Shep-pard/stmbl/hw/kicad/Chopper_v2/doc/Unbenannt.PNG

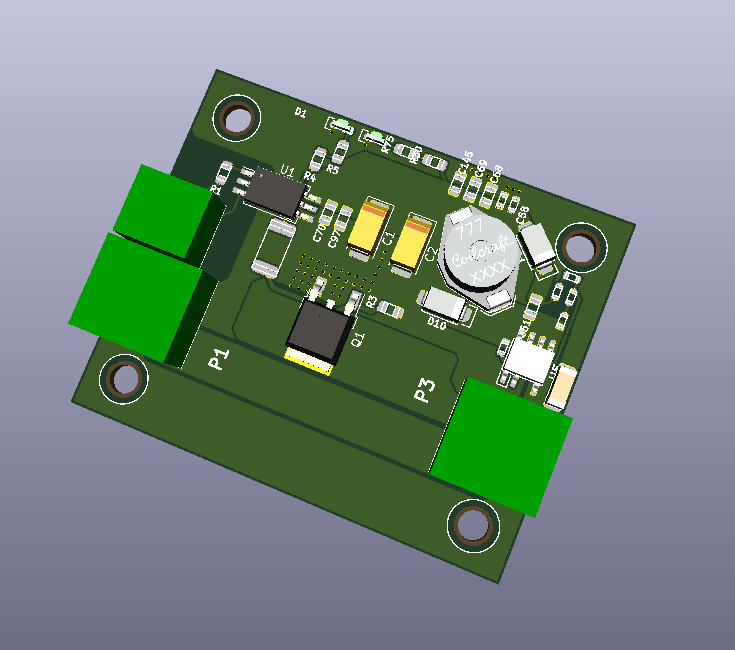
hw/kicad/Chopper_v2/doc/Unbenannt.PNG
