Shep-pard/stmbl/hw/kicad/v4.012/v4.0/doc/TeilePositionen.pptx

SMAJ24A

G

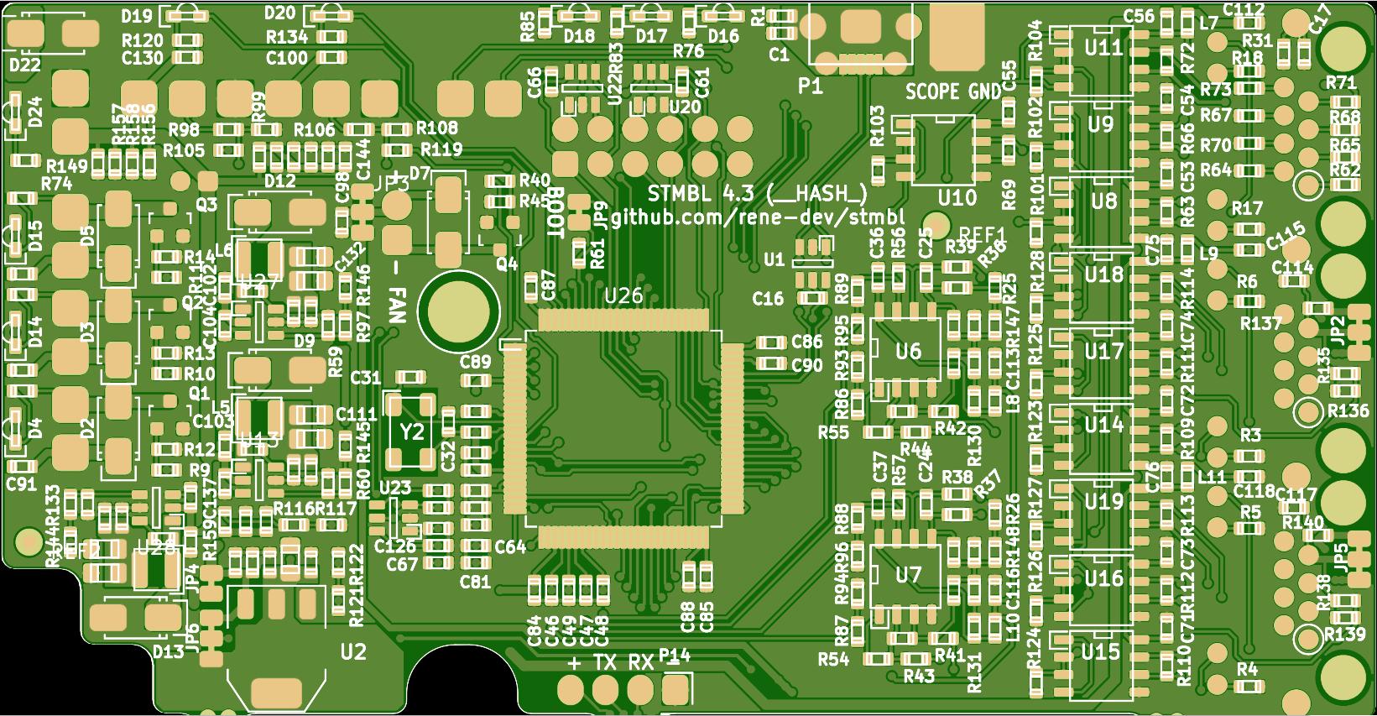
[picture p2: figure]

LED G

LED G

LED G

Y

R

G

L6 10u

G

ACT4088

G

L5 4.7u

8Mhz

ACT4088

ACT4088

L12 4.7u

U2 zldo1117

## Slide 2

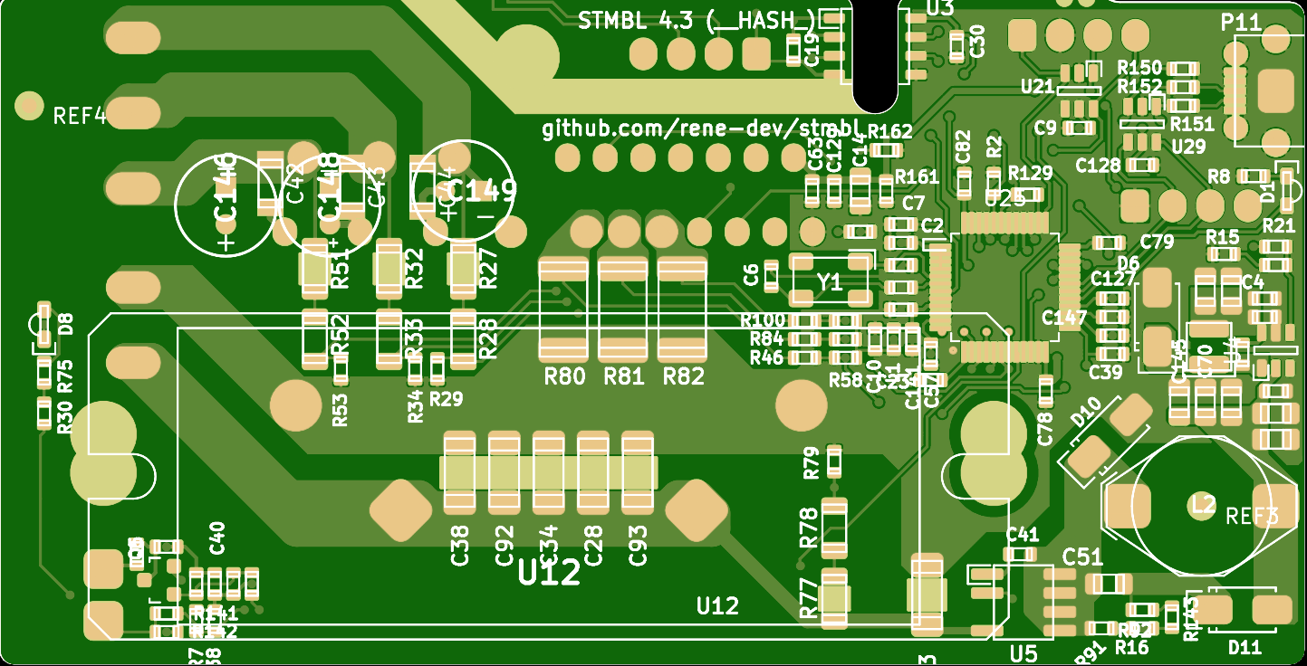
[picture p3: figure]

SI8621

3x22uF

LED R

LED G

3x3mΩ

8Mhz

L4 10u

ACT4088

18pF back

5x150nF

L2 1mH

150nF

LNK
304D
