Shep-pard/stmbl/hw/kicad/Copper/doc/Bestueckung.PNG

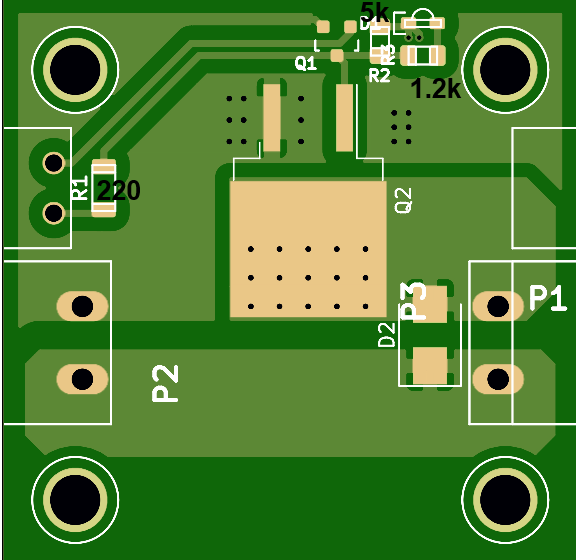
hw/kicad/Copper/doc/Bestueckung.PNG
