Shep-pard/stmbl/hw/kicad/v4.012/v4.0/doc/GerberView.PNG

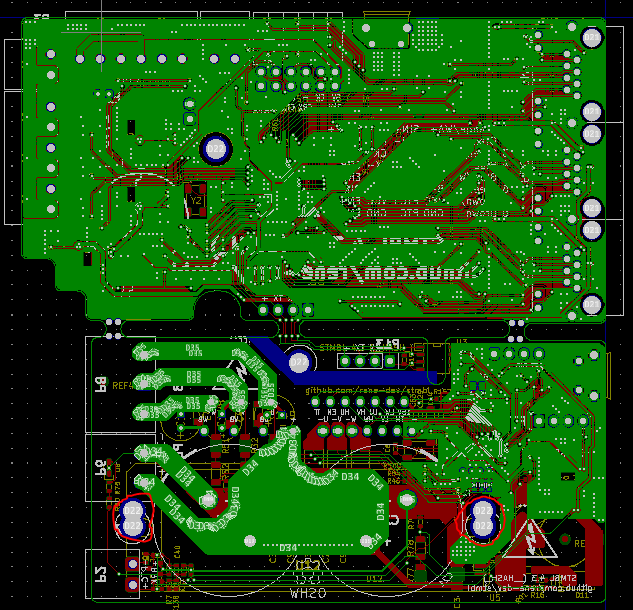
hw/kicad/v4.012/v4.0/doc/GerberView.PNG
