Shep-pard/stmbl/hw/kicad/v4.012/v4.0/doc/Stecker.PNG

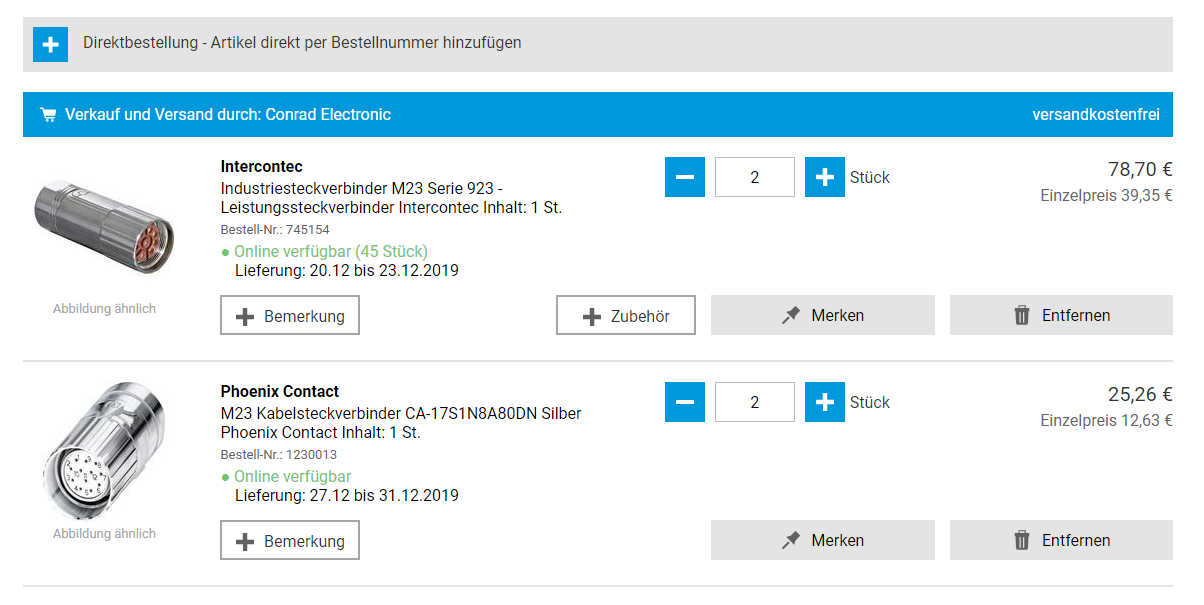
hw/kicad/v4.012/v4.0/doc/Stecker.PNG
