Shep-pard/stmbl/hw/kicad/Copper/doc/JLCSMT_BOM.xlsx

Comment | Designator | Footprint | LCSC Part #
220 | R1 | R_1206 | C17958
5k | R2 | R_1206 | C17936
2N7002 | Q1 | SOT-23 | C8545
 | Q2 | TO-263-2 | C314017
