Shep-pard/stmbl/hw/kicad/v4.012/v4.0/doc/JLCSMT_BOM_2.xlsx

Comment | Designator | Footprint | LCSC Part #
100nF | C19,C30,C127,C138,C40,C78,C79,C82,C83,C2,C7,C10,C9,C128,C58,C41,C15,C60,C63,C147,C106,C105,C96,C108,C107,C103,C104,C99,C121,C122,C120,C53,C54,C55,C56,C17,C112,C72,C74,C75,C13,C36,C113,C115,C114,C125,C71,C73,C76,C12,C37,C116,C118,C117,C126,C91,C94,C95,C100,C130,C98,C89,C87,C86,C85,C84,C80,C77,C29,C16,C119,C1,C61,C66,C67 | 0603_C | C14663
10uF | C51,C35,C68,C69,C4,C97,C70,C145,C14,C110,C109,C111,C123,C124,C132,C131 | 0805_C | C15850
18pF | C5,C6,C11,C20,C23,C39,C33,C45,C57,C25,C27,C24,C26,C31,C32 | 0603_C | C1647
2.2uF | C141,C50,C42,C43,C44,C129,C18,C8,C101,C102,C136,C135,C134,C137,C133,C62,C139,C140,C142,C144,C90,C88,C65 | 0603_C | C23630
1nF | C47,C48,C46,C49,C52,C59,C81,C64 | 0603_C | C1588
120? | R31,R109,R111,R114,R24,R25,R130,R110,R112,R113,R23,R26,R131,R1 | 0603_R | C22787
1K? | R162,R165,R2,R129,R118,R91,R75,R30,R15,R16,R145,R63,R66,R69,R72,R101,R102,R103,R104,R123,R125,R128,R136,R124,R126,R127,R139,R12,R13,R14,R45,R119,R108,R105,R99,R117,R121,R122,R61,R153 | 0603_R | C21190
470? | R8,R46,R84,R100,R17,R18,R3,R6,R93,R95,R4,R5,R94,R96,R134,R120,R85,R83,R76 | 0603_R | C23179
10K? | R142,R7,R115,R35,R132,R158,R155,R156,R157,R62,R64,R65,R67,R68,R70,R71,R73,R42,R44,R36,R39,R137,R135,R41,R43,R37,R38,R140,R138,R106,R98,R116 | 0603_R | C25804
22? | R163,R167,R151,R152,R154,R159,R160,R86,R89,R147,R87,R88,R148,R9,R10,R11,R40 | 0603_R | C23345
15K? | R92,R19,R58,R90,R107,R47,R55,R50,R56,R48,R54,R49,R57 | 0603_R | C22809
3.9K? | R164,R166,R161,R29,R34,R53,R79,R59,R146,R144,R149,R20,R22,R74 | 0603_R | C23018
51K? | R141,R21,R97,R60,R133 | 0603_R | C23196
249K? | R27,R28,R32,R33,R51,R52,R77,R78 | 1206_R | C37158
1.5K? | R143,R150 | 0603_R | C22843
LM358 | U6,U7 | SOIC-8-N | C7950
SN65176B | U8,U9,U10,U11,U14,U17,U18,U15,U16,U19 | SOIC-8-N | C31302
STM32F303CBTx | U25 | LQFP-48_7x7mm_Pitch0.5mm | C108516
STM32F405VG | U26 | LQFP-100_14x14mm_Pitch0.5mm | C56621
USBLC6-4SC6 | U21,U29,U1,U23,U20,U22 | SOT-23-6 | C252436
ES1J R2 | D10,D11,D2,D3,D5,D7 | DO-214AC | C84166
220r 700mA | L1,L7,L8,L9,L10,L11,L3 | 0603_R | C98286
SS34A | D6,D12,D9,D13 | stmbl:SMA_Standard | C183891
IRLML6344 | Q5,Q1,Q2,Q3,Q4 | stmbl:SOT-23 | C53550
