Shep-pard/stmbl/hw/kicad/v4.012/v4.0/doc/Bauteile.xlsx

Val | Designator | Package
ACT4088 | U4,U13,U28,U27 | stmbl:SOT-23-6 | Pin 1 ist am F. Die zwei minus zeichen sind an pin 5.
10µH 1A | L4,L6 | stmbl:SMD_INDUCTOR_32x25
4.7ÂµH 1.5A | L5,L12 | stmbl:SMD_INDUCTOR_32x25
1m 250mA | L2 | stmbl:NPI31W
SI8621 | U3 | stmbl:SOIC-8-N
zldo1117 | U2 | SOT-223 | Pin 1 ist am F. Die zwei minus zeichen sind an pin 5.
LNK?304D | U5 | SOIC-7
STK554U392A | U12 | stmbl:IRAM256
8M | Y1,Y2 | Crystal_SMD_0503_4Pads
270µH | C21,C22 | stmbl:C_Radial_D26_L45_P10 | Die fetten 330uF
150n | C3,C28,C34,C38,C93,C92 | stmbl:C_1808
USB_OTG | P11,P1 | stmbl:USB_Micro-B
0.003 | R80,R81,R82 | stmbl:R_2512
SMAJ24A TVS 24V | D22 | stmbl:SMA_Standard
red | D1,D16 | stmbl:LED-0805-SIDE | Der grüne Strich ist je minus
yellow | D17 | stmbl:LED-0805-SIDE | Der grüne Strich ist je minus
green | D8,D24,D4,D14,D15,D20,D19,D18 | stmbl:LED-0805-SIDE | Der grüne Strich ist je minus
47uF | C146,148,149 | For STK Other Possibility! | Andere Möglichkeit als bootstrapping C
22uF | C146,148,149 | For STK
18pF | C20,C33,C45 | moved filter caps | die drei Cs auf der Rückseite der HV Platine
2.2uF | C42,43,44 | When using IRAM!
22uF | C143 | stmbl:C_Radial
Bridge Rectifier
CONN_02X06 | P10 | stmbl:Socket_Strip_Angled_2x06 | Pinheader hat man ja immer irgendwo :D
CONN_01X04 | P12,P7 | stmbl:Pin_Header_Straight_1x04
CONN_01X04 | P13 | stmbl:Socket_Strip_Straight_1x04
CONN_01X02 | P4 | stmbl:Pin_Header_Angled_1x02
CONN_01X04 | P14 | stmbl:Pin_Header_Angled_1x04
CONN_01X02 | P2,P3,P15 | stmbl:RM3.5_1x2
 |  | stmbl:RM3.5_1x2_plug
CONN_01X02 | P6 | stmbl:RM5.08_1x2
 |  | stmbl:RM5.08_1x2_plug
CONN_01X03 | P8 | stmbl:RM5.08_1x3
 |  | stmbl:RM5.08_1x3_plug
CONN_01X06 | P5,P9 | stmbl:RM3.5_1x6
 |  | stmbl:RM3.5_1x6_plug
