Shep-pard/stmbl/hw/kicad/v4.012/v4.0/doc/RestlicheBauteile.xlsx

Val | Designator | Package | JLC_Nbr | Manufacturer | Product ID |  |  | Amount: | Cost Single | Cost total | Platform
ACT4088 | U4,U13,U28,U27 | stmbl:SOT-23-6 | C11135 | Active-Semi | ACT4088US-T (https://lcsc.com/product-detail/DC-DC-Converters_ACTIVE-SEMI-ACT4088US-T_C11135.html) |  |  | 4 | 0.41 € | 1.64 € | lcsc
10ÂµH 1A | L4,L6 | stmbl:SMD_INDUCTOR_32x25 |  | Murata | LQH32PN100MNCL (https://lcsc.com/product-detail/Power-Inductors_Murata-Electronics-LQH32PN100MNCL_C86073.html) |  |  | 2 | 0.468 | 0.94 € | mouser
1m 250mA | L2 | stmbl:NPI31W | C280665 | Coilcraft | SSL0804T-102M-N (https://lcsc.com/product-detail/_Chilisin-Elec-SSL0804T-102M-N_C280665.html) |  |  | 1 | 0.2222 | 0.22 € | lcsc
CONN_01X04 | P14 | stmbl:Pin_Header_Angled_1x04 | C293357 |  | 901210764 (https://lcsc.com/product-detail/Pin-Header-Female-Header_MOLEX-901210764_C293357.html) |  |  | 1 | 0.31 | 0.31 € | lcsc
CONN_01X02 | P2,P3,P15 | stmbl:RM3.5_1x2 | C395830 | DIBO | DB2ERC-3.5-2P (https://lcsc.com/product-detail/Pluggable-System-Terminal-Block_DIBO-DB2ERC-3-5-2P_C395830.html) |  |  | 3 | 0.033 | 0.10 € | lcsc
 |  | stmbl:RM3.5_1x2_plug | C395828 | DIBO | DB2EK-3.5-2P (https://lcsc.com/product-detail/Pluggable-System-Terminal-Block_DIBO-DB2EK-3-5-2P_C395828.html) |  |  | 3 | 0.099 | 0.30 € | lcsc
CONN_01X02 | P6 | stmbl:RM5.08_1x2 | C3697 | DIBO | WJ2EDGRC-5.08-2P (https://lcsc.com/product-detail/Pluggable-System-Terminal-Block_Ningbo-Kangnex-Elec-WJ2EDGRC-5-08-2P_C3697.html) |  |  | 1 | 0.0233 | 0.02 € | lcsc
 |  | stmbl:RM5.08_1x2_plug | C71370 | DIBO | WJ2EDGK-5.08-2P (https://lcsc.com/product-detail/Pluggable-System-Terminal-Block_Ningbo-Kangnex-Elec-WJ2EDGK-5-08-2P_C71370.html) |  |  | 1 | 0.0953 | 0.10 € | lcsc
CONN_01X03 | P8 | stmbl:RM5.08_1x3 | C8377 | DIBO | WJ2EDGRC-5.08-3P (https://lcsc.com/product-detail/Pluggable-System-Terminal-Block_Ningbo-Kangnex-Elec-WJ2EDGRC-5-08-3P_C8377.html) |  |  | 1 | 0.0349 | 0.03 € | lcsc
 |  | stmbl:RM5.08_1x3_plug | C71371 | DIBO | WJ2EDGK-5.08-3P-14-00A (https://lcsc.com/product-detail/Pluggable-System-Terminal-Block_Ningbo-Kangnex-Elec-WJ2EDGK-5-08-3P-14-00A_C71371.html) |  |  | 1 | 0.1336 | 0.13 € | lcsc
CONN_01X06 | P5,P9 | stmbl:RM3.5_1x6 | C39583 | DIBO | DB2EK-3.5-6P (https://lcsc.com/product-detail/Pluggable-System-Terminal-Block_DIBO-DB2EK-3-5-6P_C395838.html) |  |  | 2 | 0.099 | 0.20 € | lcsc
 |  | stmbl:RM3.5_1x6_plug | C395838 | DIBO | DB2ERC-3.5-6P (https://lcsc.com/product-detail/Pluggable-System-Terminal-Block_DIBO-DB2ERC-3-5-6P_C395837.html) |  |  | 2 | 0.217 | 0.43 € | lcsc
zldo1117 | U2 | SOT-223 | C326523 |  | ZLDO1117QG33TA (https://lcsc.com/product-detail/Linear-Voltage-Regulators_Diodes-Incorporated-ZLDO1117QG33TA_C326523.html) |  |  | 1 | 0.297 | 0.30 € | lcsc
LNK?304D | U5 | SOIC-7 | C37448 |  | LNK304DN-TL (https://lcsc.com/product-detail/Switching-Controllers_POWER-INTEGRATIONS-LNK304DN-TL_C37448.html) |  |  | 1 | 0.569 | 0.57 € | lcsc
8M | Y1,Y2 | Crystal_SMD_0503_4Pads | C276420 |  | ABM3B-8.000MHZ-10-1-U-T (https://lcsc.com/product-detail/SMD-Crystal-Resonators_Abracon-LLC-ABM3B-8-000MHZ-10-1-U-T_C276420.html) |  |  | 2 | 0.35 € | 0.70 € | lcsc
270Âµ | C21,C22 | stmbl:C_Radial_D26_L45_P10 |  | United Chemi-Con | ESMR401VSN271MQ30S |  | 400V | 2 | 0 | 0.00 €
150n | C3,C28,C34,C38,C93,C92 | stmbl:C_1808 |  | KEMET | C1808W154KCRACTU | X7R | 500V | 6 | 0.63 € | 3.78 € | mouser
4.7ÂµH 1.5A | L5,L12 | stmbl:SMD_INDUCTOR_32x25 |  | Murata | LQH32PN4R7NNC |  |  | 2 | 0.468 | 0.94 € | mouser
CONN_02X06 | P11,P1 | stmbl:USB_Micro-B |  | Molex | 105017-0001 |  |  | 2 | 0.774 | 1.55 € | mouser
USB_OTG | P10 | stmbl:Socket_Strip_Angled_2x06 |  | das hat doch echt jeder! |  |  |  | 1 |  | 0.00 €
CONN_01X04 | P12,P7 | stmbl:Pin_Header_Straight_1x04 |  |  |  |  |  | 2 |  | 0.00 €
CONN_01X04 | P13 | stmbl:Socket_Strip_Straight_1x04 |  |  |  |  |  | 1 |  | 0.00 €
CONN_01X02 | P4 | stmbl:Pin_Header_Angled_1x02 |  |  |  |  |  | 1 |  | 0.00 €
SI8621 | U3 | stmbl:SOIC-8-N |  | Silicon Labs | Si8621BB-B-IS |  |  | 1 | 1.32 | 1.32 € | mouser
0.003 | R80,R81,R82 | stmbl:R_2512 |  | Bourns | CSS2H-2512K-3L00F |  | 1% | 3 | 0.864 | 2.59 € | mouser
IRAM256a | U12 | stmbl:IRAM256 |  | Onsemi | STK554U392A |  |  | 1 | 10.00 € | 10.00 € | ali | https://de.aliexpress.com/item/32983001276.html
red | D1,D16 | stmbl:LED-0805-SIDE | C284935 | Lite-On | LTST-S220KRKT (https://lcsc.com/product-detail/Light-Emitting-Diodes-LED_Lite-On-LTST-S220KRKT_C284935.html) |  |  | 2 | 0.0376 | 0.08 € | lcsc
yellow | D17 | stmbl:LED-0805-SIDE | C264355 | Lite-On | 12-215/Y2C-CQ1R1B/3C (https://lcsc.com/product-detail/Others_Everlight-Elec-12-215-Y2C-CQ1R1B-3C_C264355.html) |  |  | 1 | 0.0415 | 0.04 € | lcsc
SMAJ24A TVS 24V | D22 | stmbl:SMA_Standard | C132947 | STMicroelectronics | SMAJ24A-TR (https://lcsc.com/product-detail/TVS_STMicroelectronics-SMAJ24A-TR_C132947.html) |  |  | 1 | 0.0742 | 0.07 € | lcsc
green | D8,D24,D4,D14,D15,D20,D19,D18 | stmbl:LED-0805-SIDE | C273623 | Lite-On | TJ-S2005SW9TGLC2G-A5 (https://lcsc.com/product-detail/Others_TOGIALED-TJ-S2005SW9TGLC2G-A5_C273623.html) |  |  | 8 | 0.0412 | 0.33 € | lcsc
47uF | C146,148,149 | For STK |  |  | EKMG500ELL470MF11D |  |  | 3 | 0.27 € | 0.81 € | mouser
22uF | C146,148,149 | For STK Other Possibility! |  |  | EKZE500ELL220ME11D |  |  | 3 | 0.26 € | 0.78 € | mouser
18pF | C20,C33,C45 | moved filter caps | C92671 |  | 0603CG180J500NT (https://lcsc.com/product-detail/Multilayer-Ceramic-Capacitors-MLCC-SMD-SMT_FH-Guangdong-Fenghua-Advanced-Tech-0603CG180J500NT_C92671.html) |  |  | 3 | 0.05 € | 0.15 € | lcsc
2.2uF | C42,43,44 | When using IRAM! | C50254 |  | CL31B225KBHNNNE (https://lcsc.com/product-detail/Multilayer-Ceramic-Capacitors-MLCC-SMD-SMT_SAMSUNG_CL31B225KBHNNNE_2-2uF-225-10-50V_C50254.html) |  |  | 3 | 0.04 € | 0.13 € | lcsc
22uF | C143 | stmbl:C_Radial | C270038 |  | LKFB41H220MF (https://lcsc.com/product-detail/Aluminum-Electrolytic-Capacitors-Leaded_Ymin-LKFB41H220MF_C270038.html) |  |  | 1 | 0.024328 | 0.02 € | lcsc
Bridge Rectifier |  |  | C3083 |  | KBPC5010 (https://lcsc.com/product-detail/Bridge-Rectifiers_MDD-Microdiode-Electronics-KBPC5010_C3083.html) |  |  | 1 | 0.85 € | 0.85 € | lcsc
 |  |  |  |  | https://de.aliexpress.com/item/539701403.html?spm=2114.13010608.0.0.JMsOXU
 |  |  |  |  |  |  |  |  |  |  |  | Anzahl Platinen
 |  |  |  |  |  |  |  |  |  |  |  | 10
 |  |  |  |  |  |  |  |  |  |  |  |  | lcsc | Mouser | ali | Platinen: | Chopper Platine
 |  |  |  |  |  |  |  |  |  |  |  | Pro Anbieter: | 127.18 € | 127.05 € | 100.00 € | 131.00 € | 8 €
 |  |  |  |  |  |  |  |  |  |  |  |  |  |  |  |  | Chopper Widerstand 1kw
 |  |  |  |  |  |  |  |  |  |  |  | Versand: | 50 € | 0 € | 10.00 € | 15 € | 30 € | https://de.aliexpress.com/item/32834739138.html?spm=a2g0x.12010612.8148356.30.371b1b72Sgr1UF
 |  |  |  |  |  |  |  |  |  |  |  | Zoll: | 48.6643254 € |  | 35.9 € | 42.74 €
 |  |  |  |  |  |  |  |  |  |  |  | Kosten gesamt: | 225.84 € | 127.05 € | 145.90 € | 188.74 €
 |  |  |  |  |  |  |  |  |  |  |  | Kosten komplett | Pro Stk
 |  |  |  |  |  |  |  |  |  |  |  | 687.53 € | 68.75 € | 106.75 €
