Shep-pard/stmbl/hw/kicad/Chopper_v2/doc/JLCSMT_BOM.xlsx

Comment | Designator | Footprint | LCSC Part #
US1M | D2 | D_SMB | C412437
10uF | C2,C1 | CP_EIA-6032-28_Kemet-C_Pad2.25x2.35mm_HandSolder
1k | R75,R30,R5,R4,R3 | R_0805 | C17513
100n | C41,C58 | C_0603 | C14663
10Âµ | C51,C68,C69,C97,C145 | C_0805 | C15850
1Âµ | C70 | C_0805 | C28323
ES1J R2 | D10,D11 | SMA_Standard | C84166
1.2k | R1 | R_0805 | C17379
1k | R16,R91 | R_0603 | C21190
15k | R92 | R_0603 | C22809
1.5k | R143 | R_0603 | C22843
3.9k | R161 | R_0603 | C23018
LNK304D | U5 | SOIC-7 | C37448
