Shep-pard/stmbl/hw/kicad/v4.012/v4.0/doc/heatsink.dxf

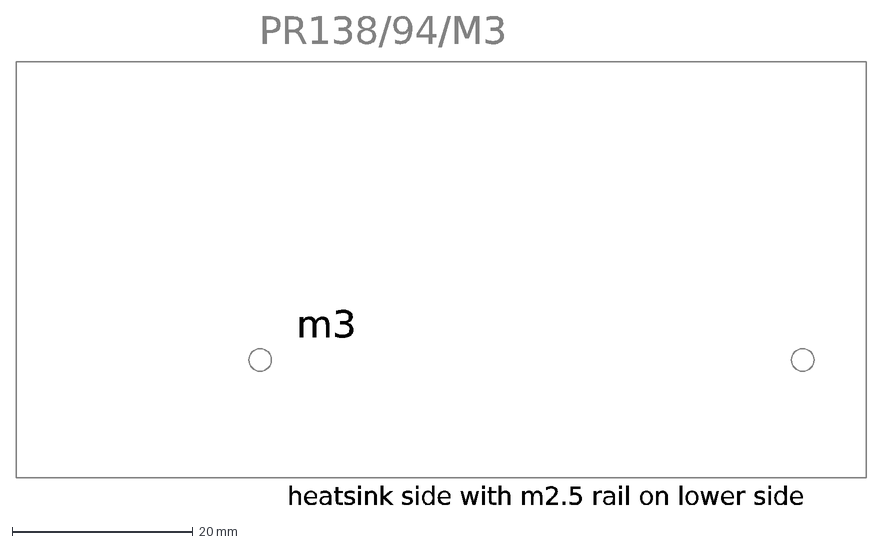
[picture p7: CAD file, 2020-04-04]
hw/kicad/v4.012/v4.0/doc/heatsink.dxf
m3
heatsink side with m2.5 rail on lower side
PR138/94/M3
