Shep-pard/stmbl/hw/tools/clip.dxf

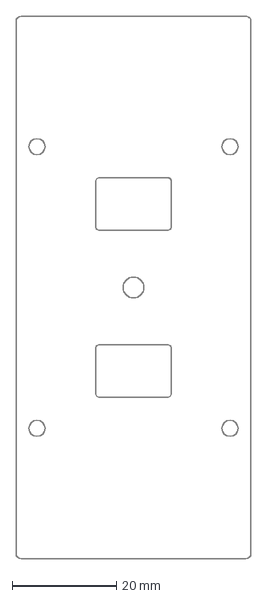
[picture p8: CAD file, 2020-04-04]
hw/tools/clip.dxf
45.0 x 104.0 mm
