Shep-pard/stmbl/(list of files, cad)

Other CAD files:
hw/kicad/v4.012/v4.0/stmbl.scad
