Shep-pard/stmbl/(threads)

Thread 1 (2023-12-27):

HW design considerations

kubabuda, 2023-12-27:
Hi,
Nice, clean job with layout for IPM in DIP style housing. I saw no sane way to fit one with 2 electrolytic cap in STMBL form factor (without bending IPM pins for SMD soldering)
1. What value/part number has that foil capacitor, and how do you pick one for this application?
2. Why did you moved 15V SMPS and coil from corner, closer to MCU? It has to introduce more noise
