Shep-pard/stmbl/hw/kicad/v4.012/v4.0/doc/stmbl_4.0.pdf

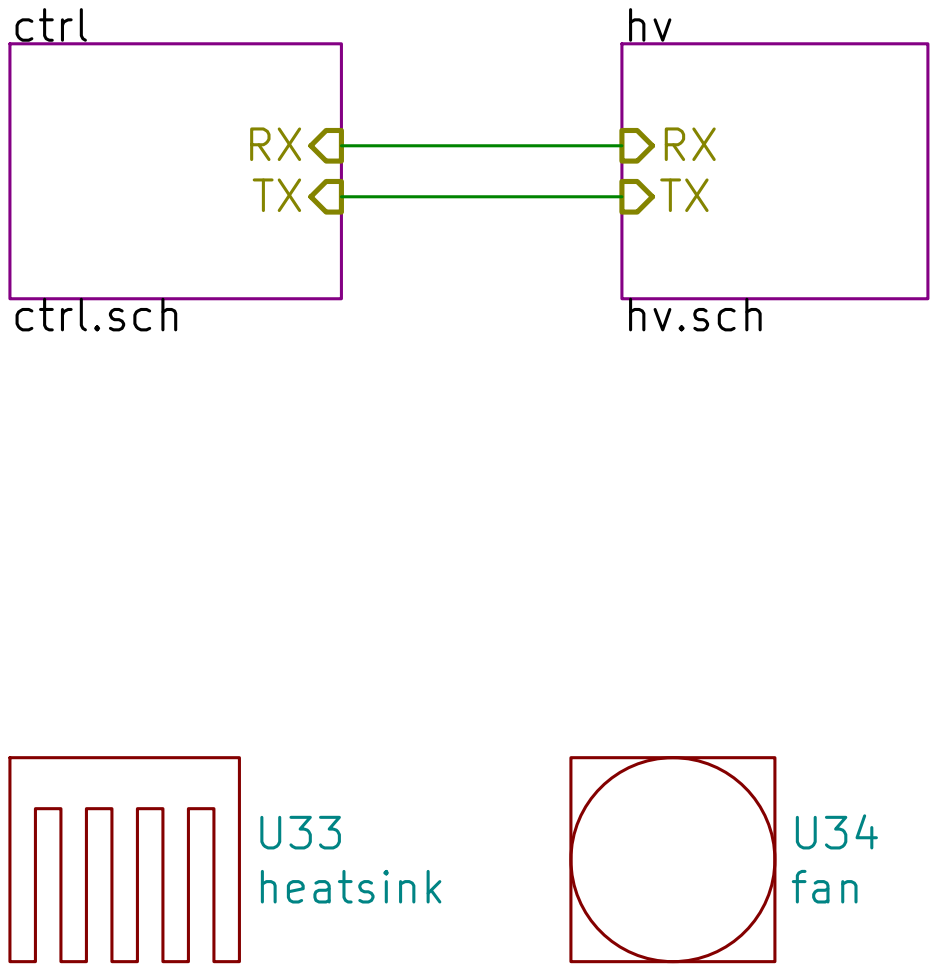
[picture p9: page 1]

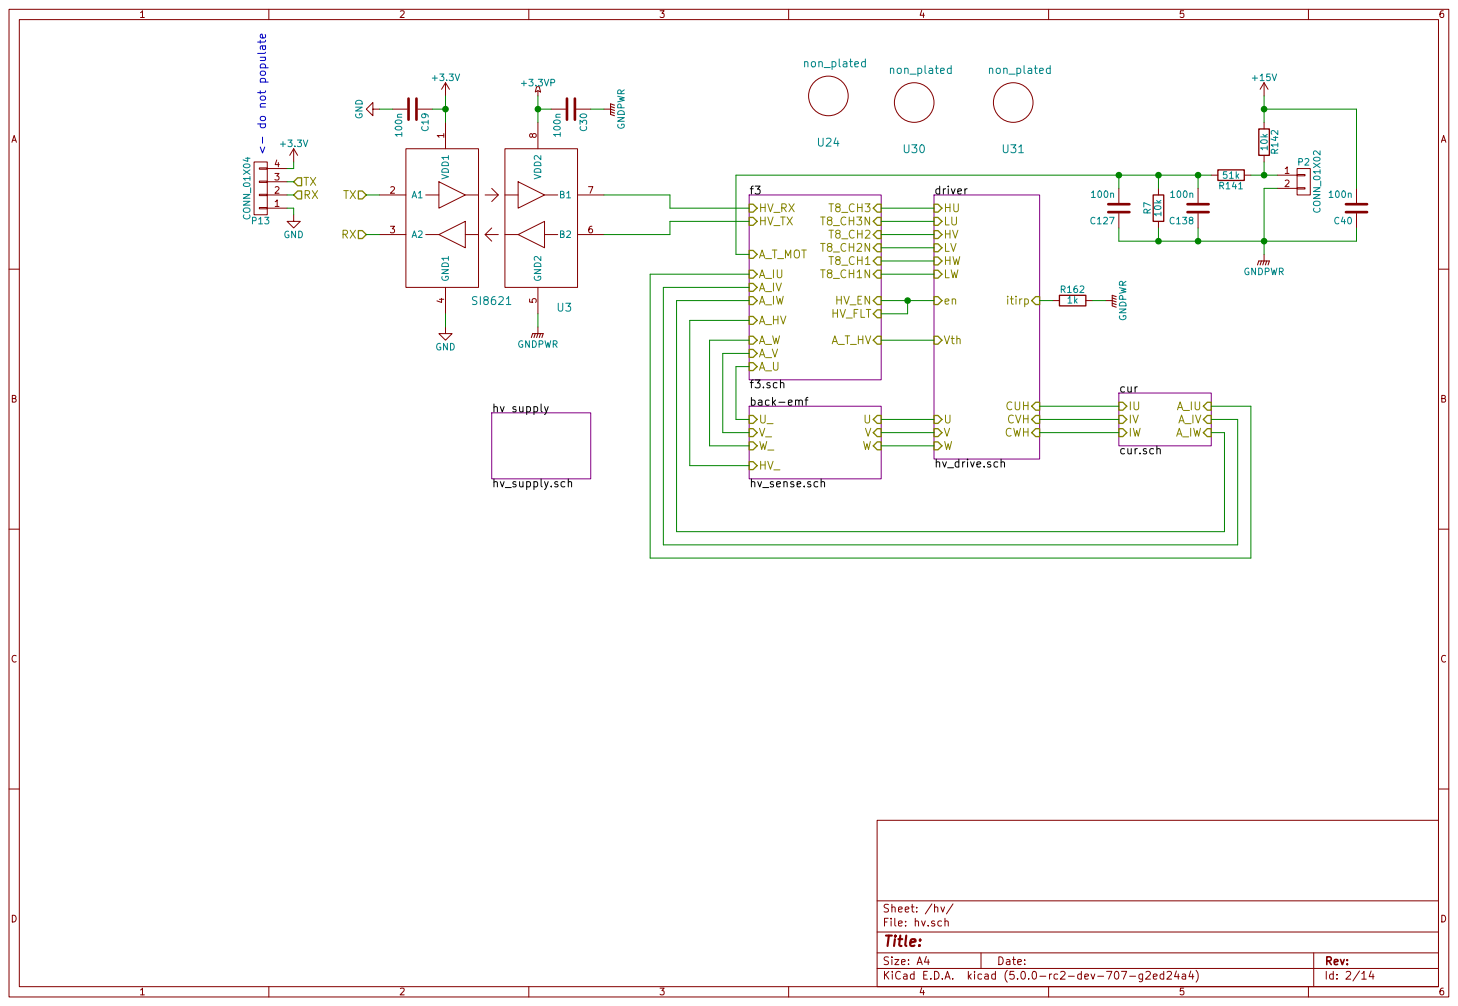
[picture p10: page 2]

Id: 2/14 Title: File: hv.sch Sheet: /hv/ VDD1

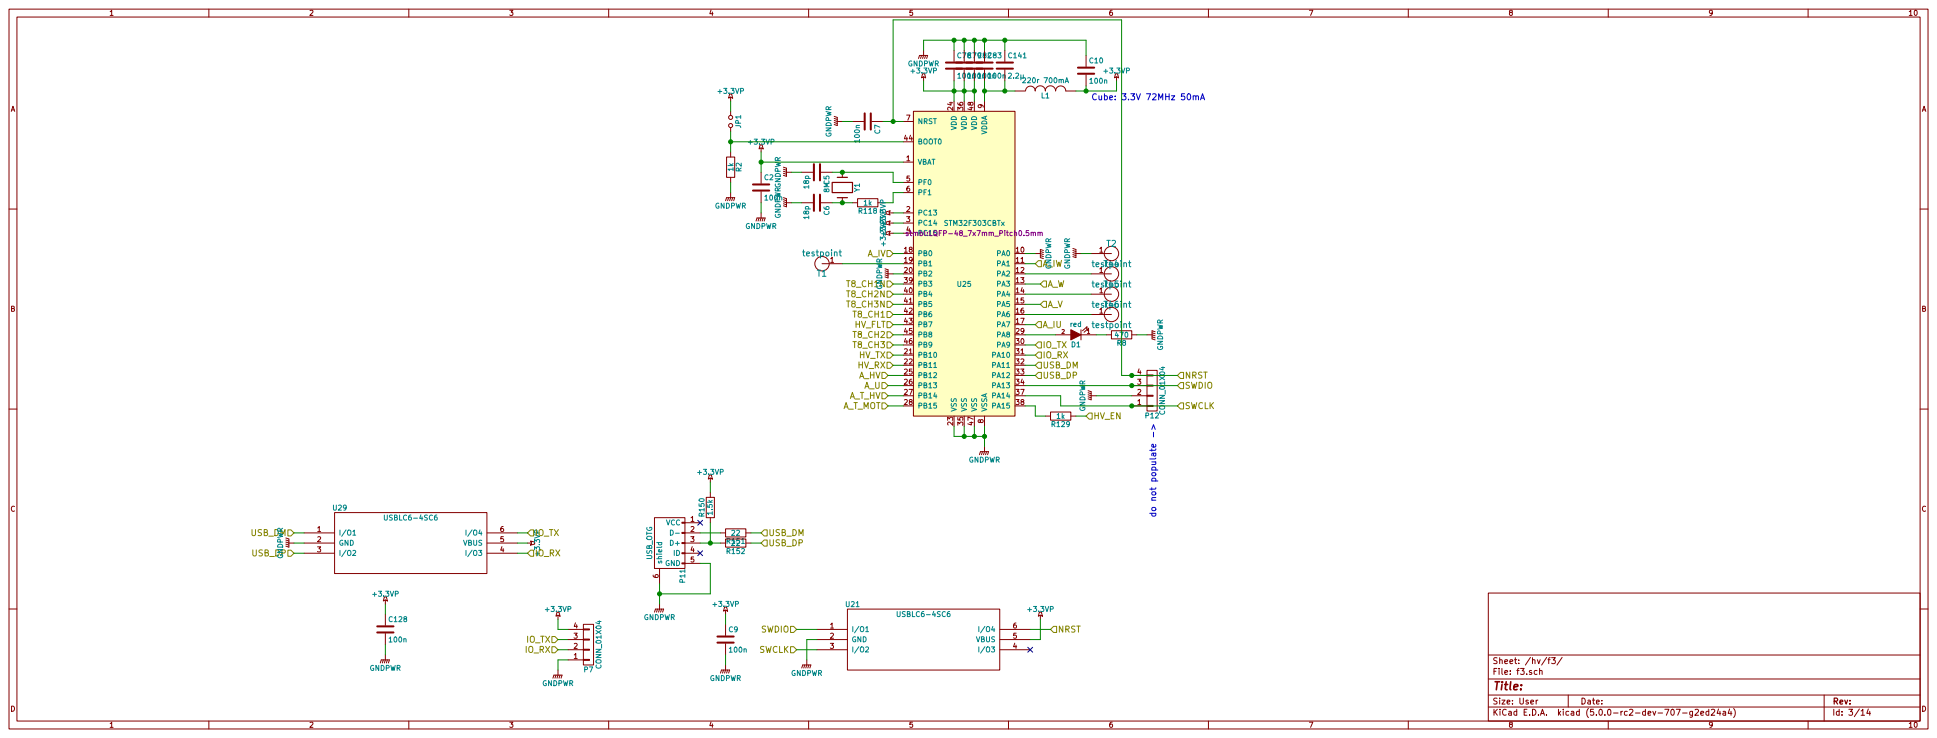
[picture p11: page 3]

Id: 3/14 Title: File: f3.sch Sheet: /hv/f3/ GNDPWR

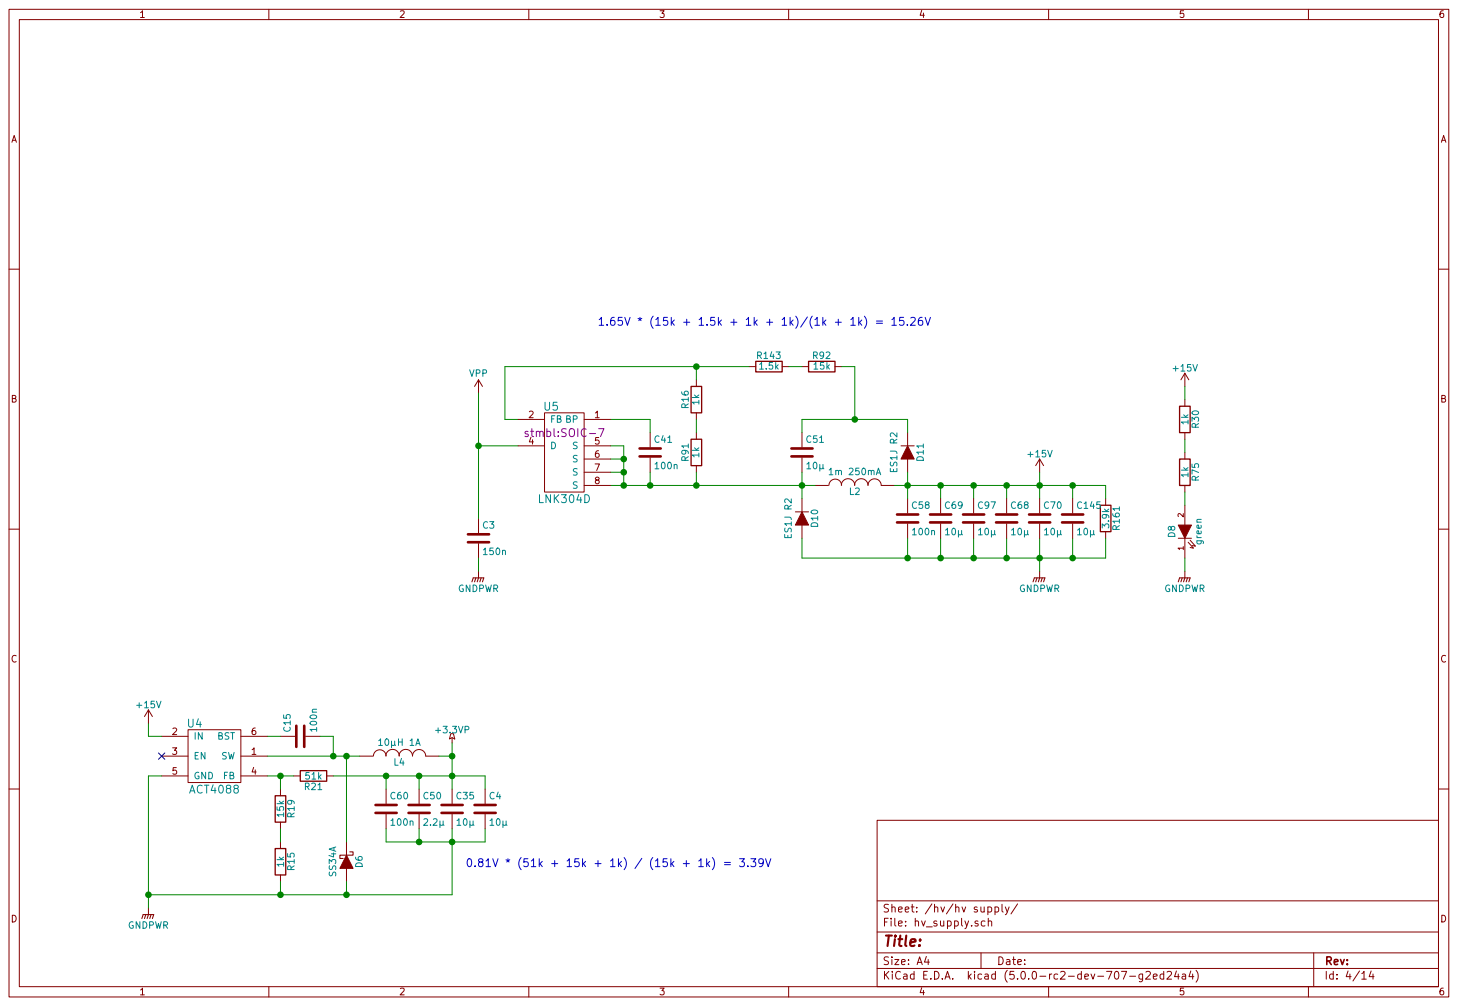
[picture p12: page 4]

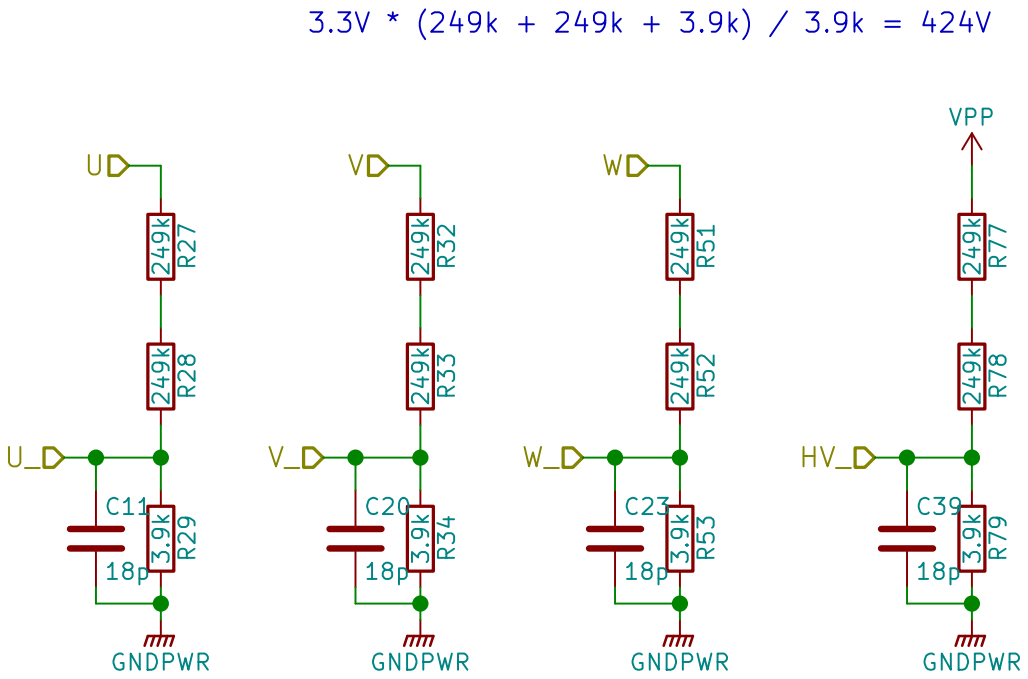
[picture p13: page 5]

File: hv_sense.sch Sheet: /hv/back-emf/ U

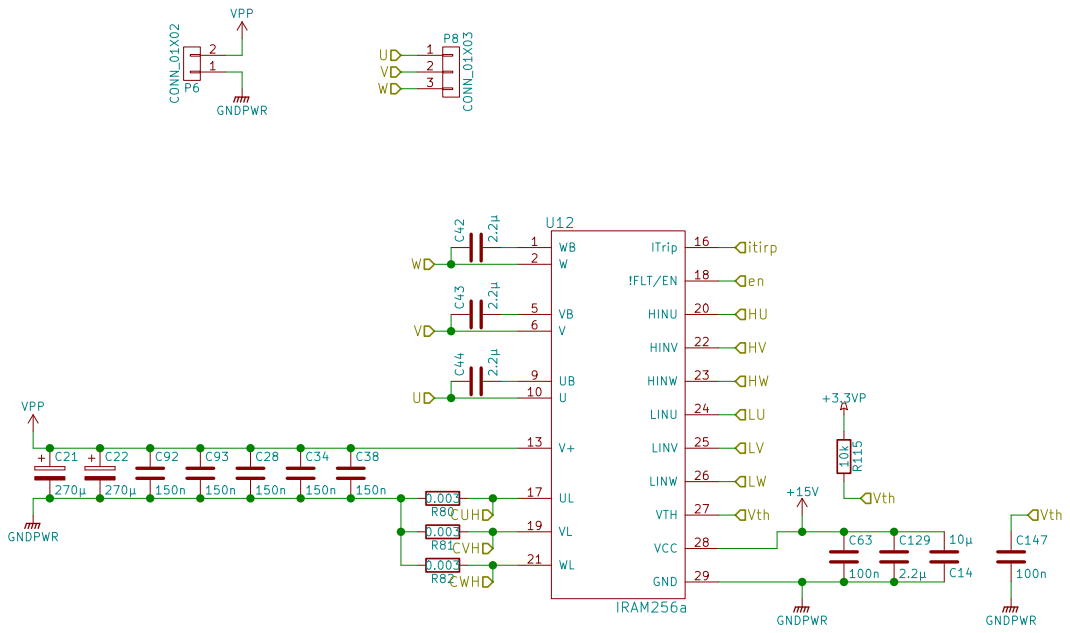
[picture p14: page 6]

File: hv_drive.sch Sheet: /hv/driver/ C21

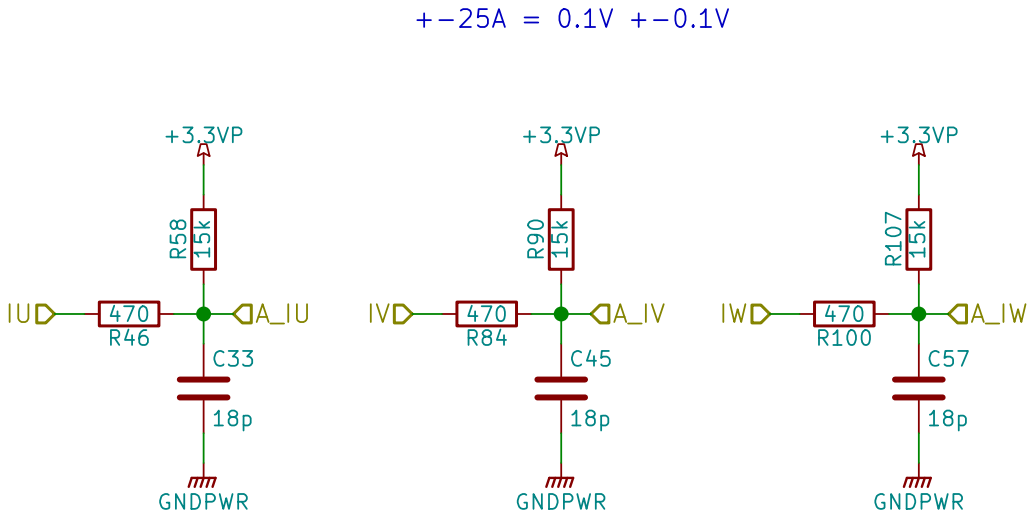
[picture p15: page 7]

Id: 7/14 Title: File: cur.sch Sheet: /hv/cur/

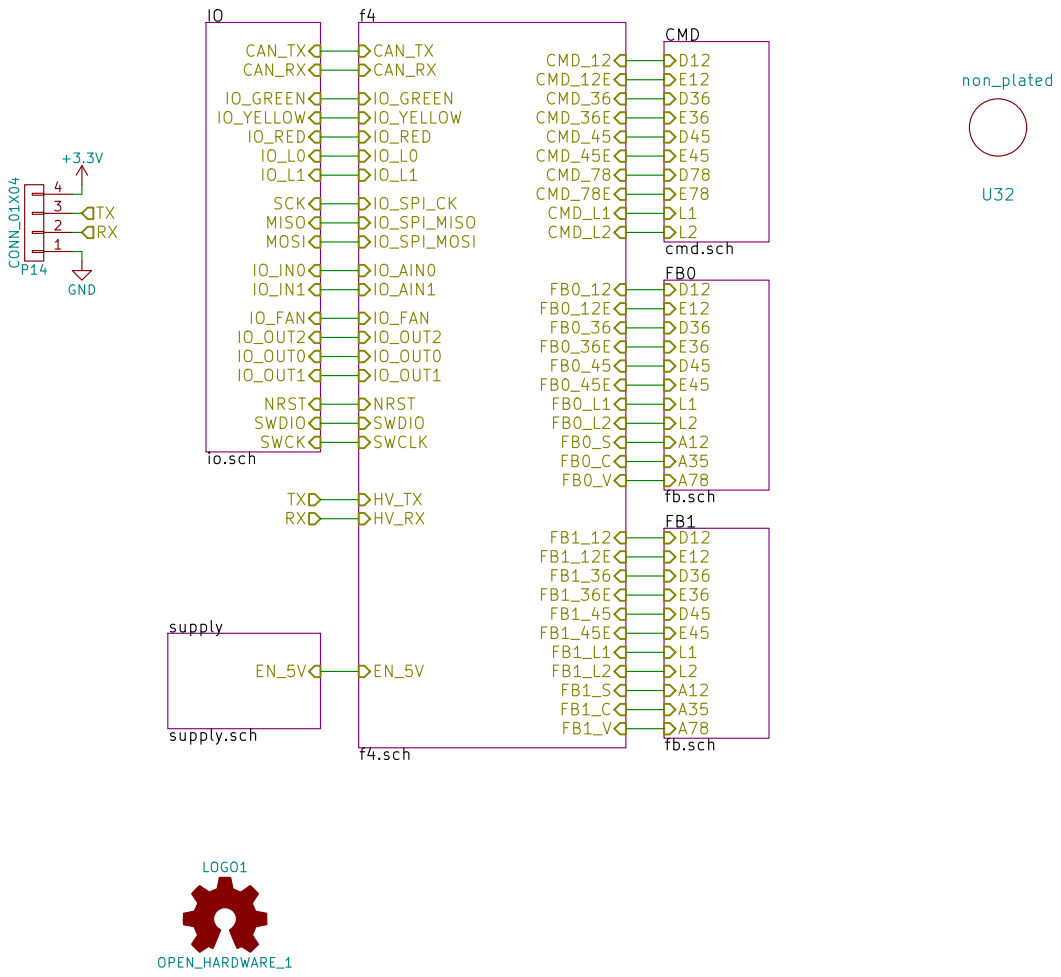
[picture p16: page 8]

Id: 8/14 Title: File: ctrl.sch Sheet: /ctrl/

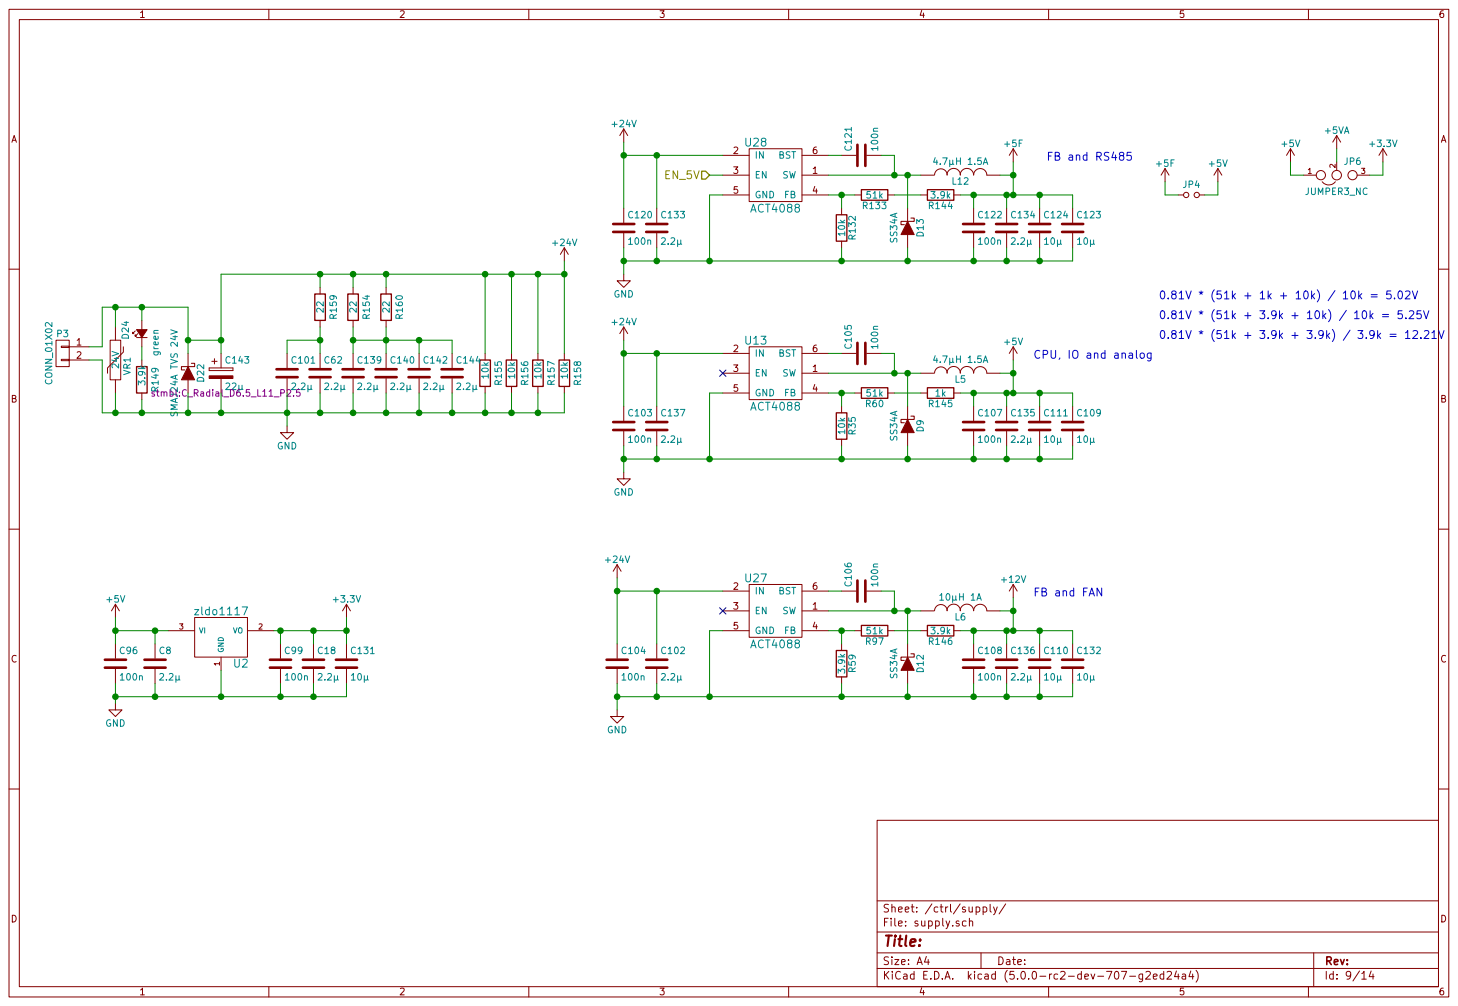
[picture p17: page 9]

CPU, IO and analog

Sheet: /ctrl/supply/ GND

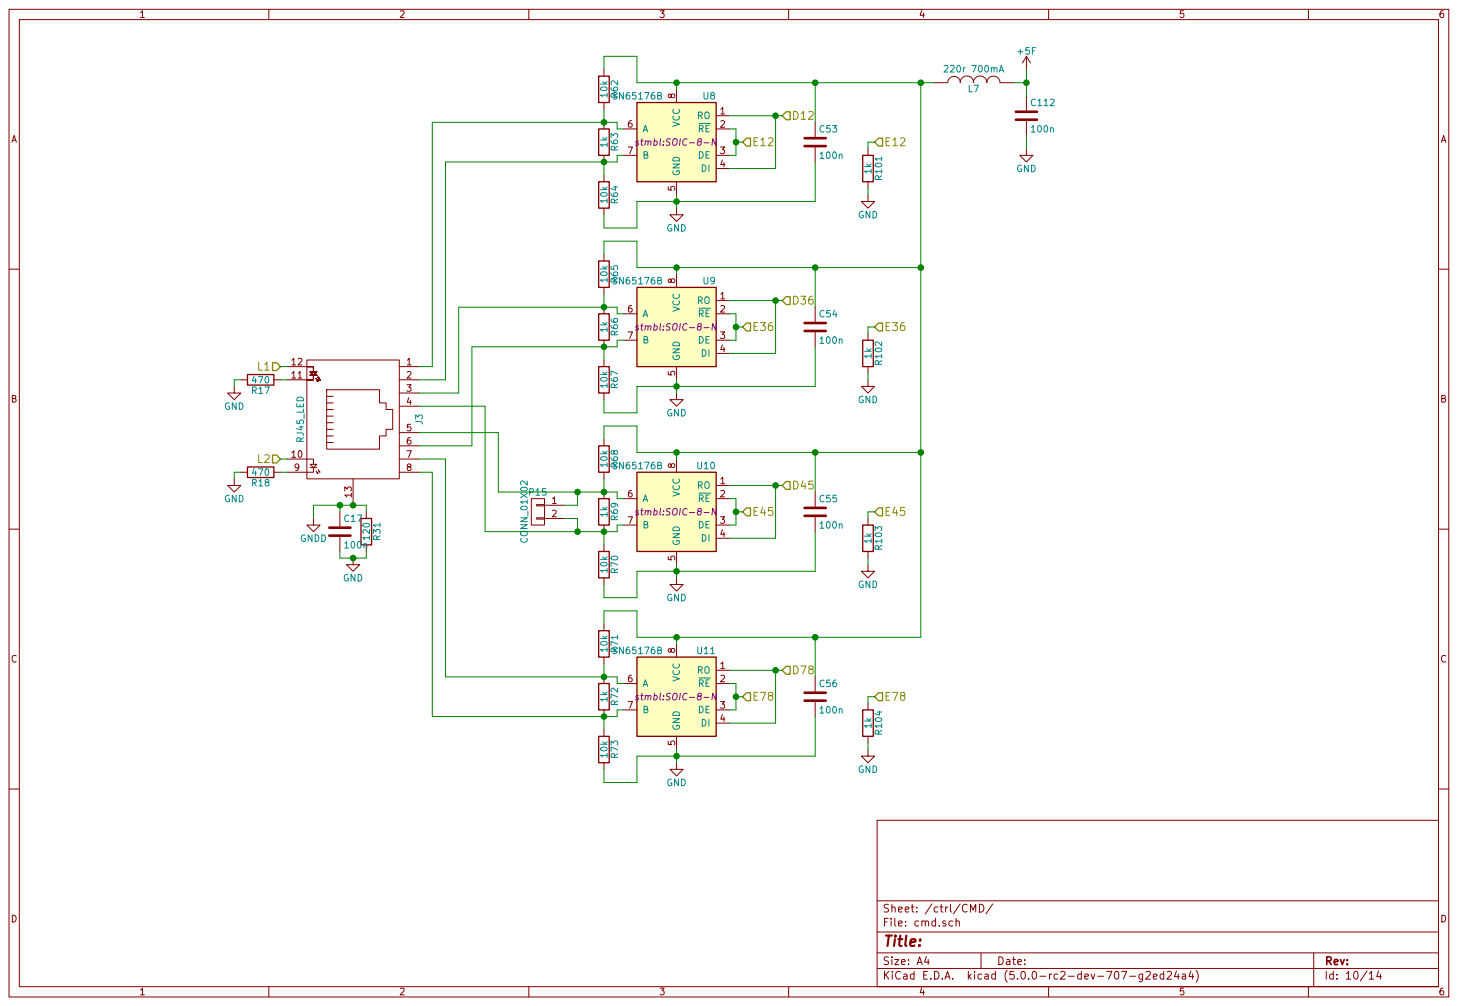
[picture p18: page 10]

Id: 10/14 Title: File: cmd.sch Sheet: /ctrl/CMD/

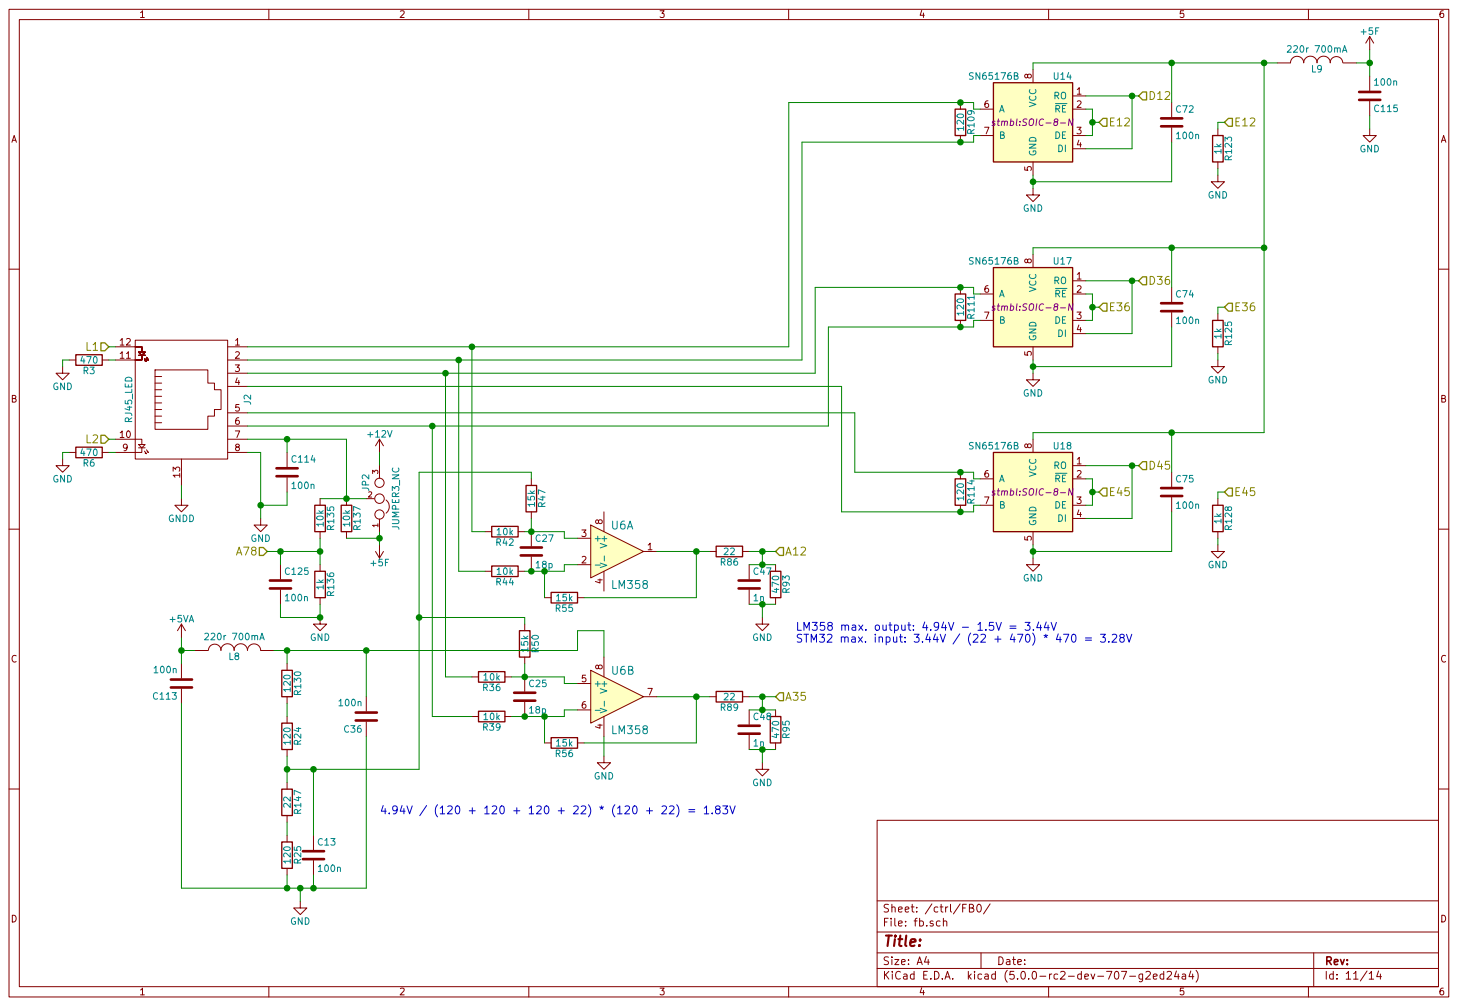
[picture p19: page 11]

Id: 11/14 Title: File: fb.sch Sheet: /ctrl/FB0/ V- 4 V+

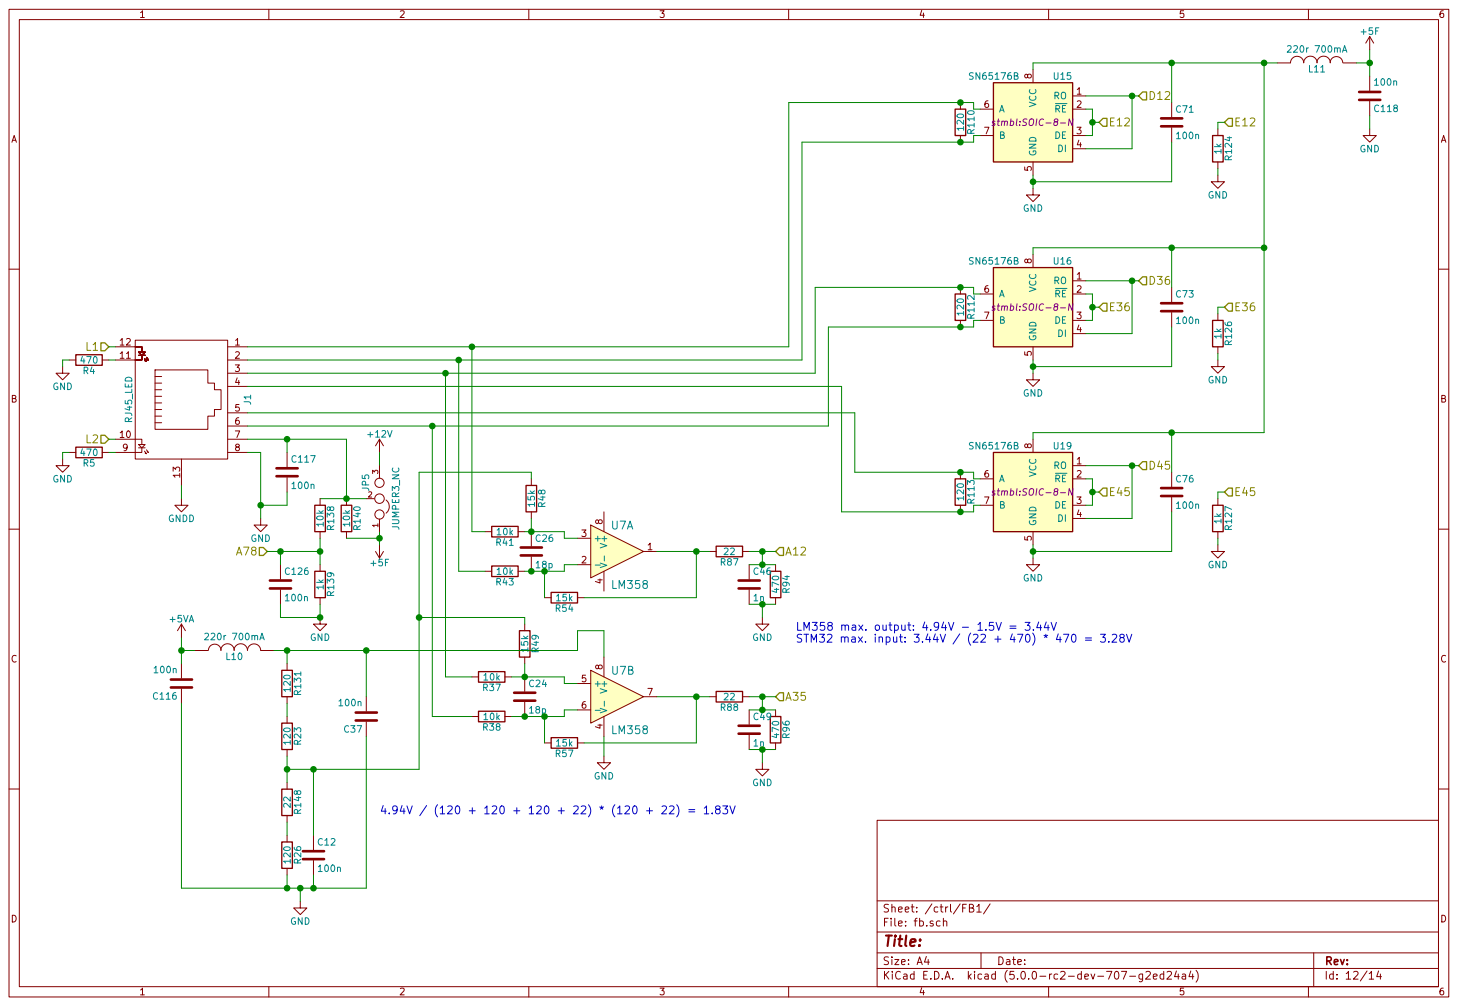
[picture p20: page 12]

Id: 12/14 Title: File: fb.sch Sheet: /ctrl/FB1/ V- 4 V+

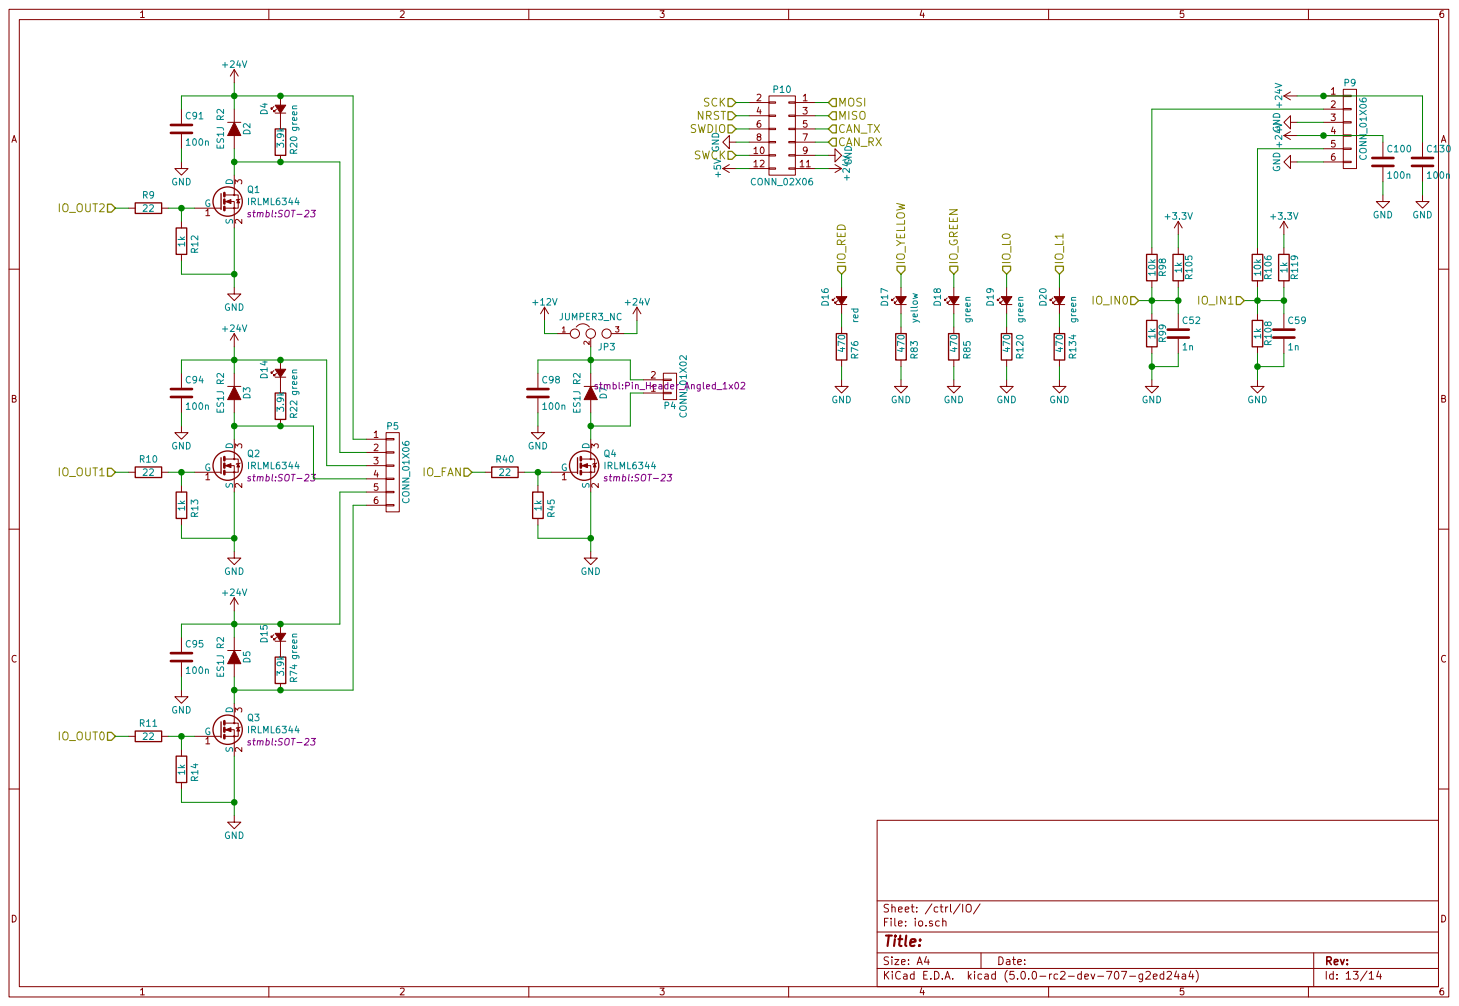
[picture p21: page 13]

Id: 13/14 Title: File: io.sch Sheet: /ctrl/IO/

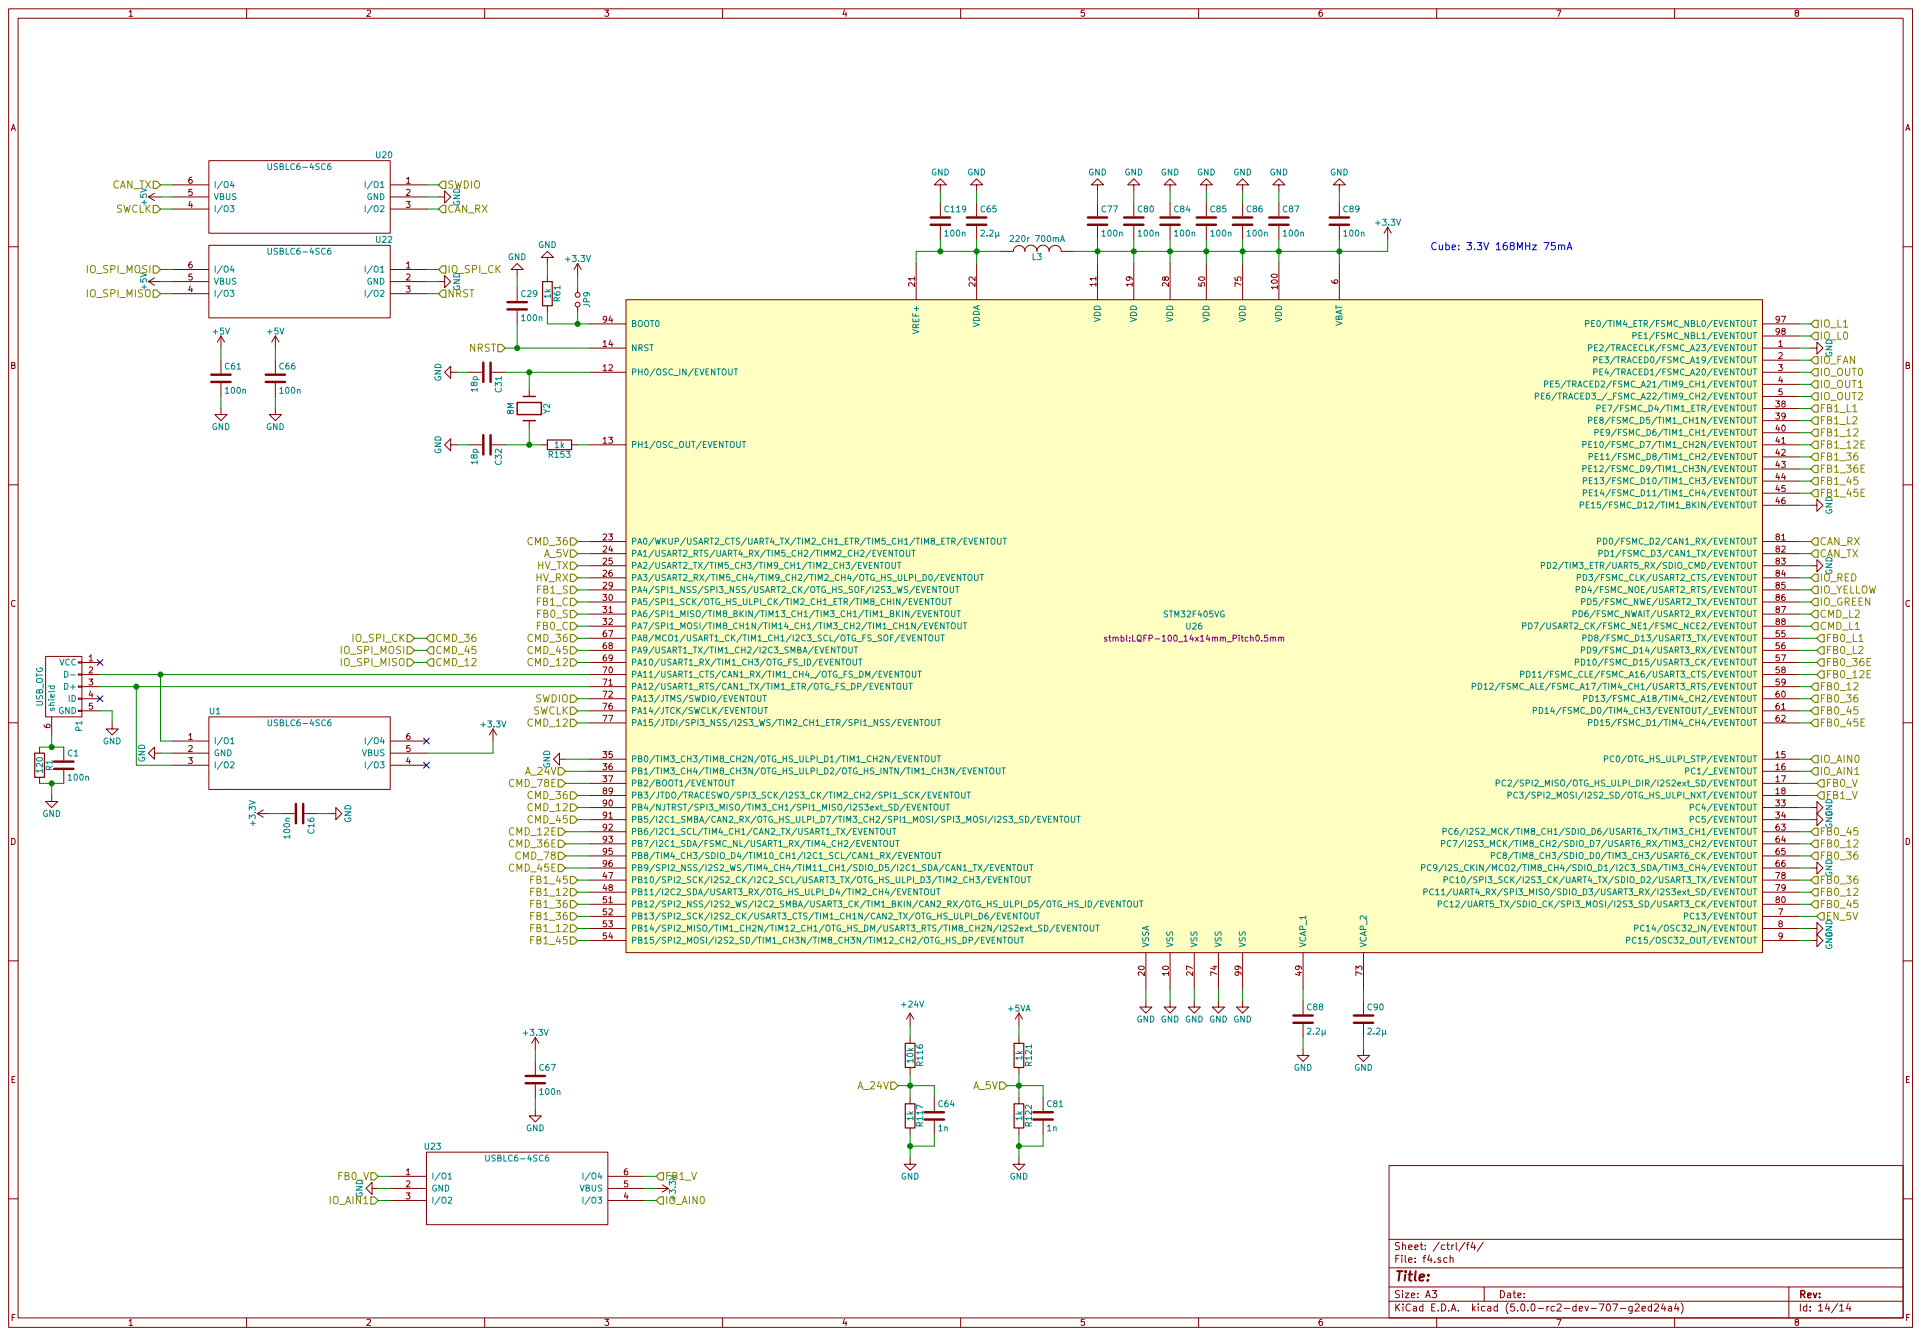
[picture p22: page 14]

Id: 14/14 Title: File: f4.sch Sheet: /ctrl/f4/
