Shep-pard/stmbl/hw/spice/strom.asc

20k: res; 20k
C1: cap; 18p
C2: cap; 18p
C3: cap; 18p
D1: diode
D2: diode
I1: current; SINE(0 30 500 0 0)
I2: current; SINE(0 30 500 0 0)
R1: res; 470
R2: res; 15k
R3: res; 1k
R4: res; 2.4k
R5: res; 7.5k
R6: res; 470
R7: res; 0.003
R8: res; 470
R9: res; 120
R10: res; 2.4k
R11: res; 1k
R12: res; 2.4k
R13: res; 2.4k
R14: res; 120
R15: res; 470
R16: res; 20k
R17: res; 0
R18: res; 100Meg
R19: res; 20k
R21: res; 0.003
U1: opamp2; lm358
U2: opamp2; lm358
U3: opamp2; lm358
V2: voltage; 3.3
V3: voltage; 0
V4: voltage; 15
Named nets: 0, opout, in, 3.3, 0V, sig, opoutl, sigl
.tran 0 2ms
.include lm358.lib
+-21A
+-5A
