Shep-pard/stmbl/hw/bla/bla/bla.kicad_pcb

## KiCad design kicad/ultrasonicradar.sch

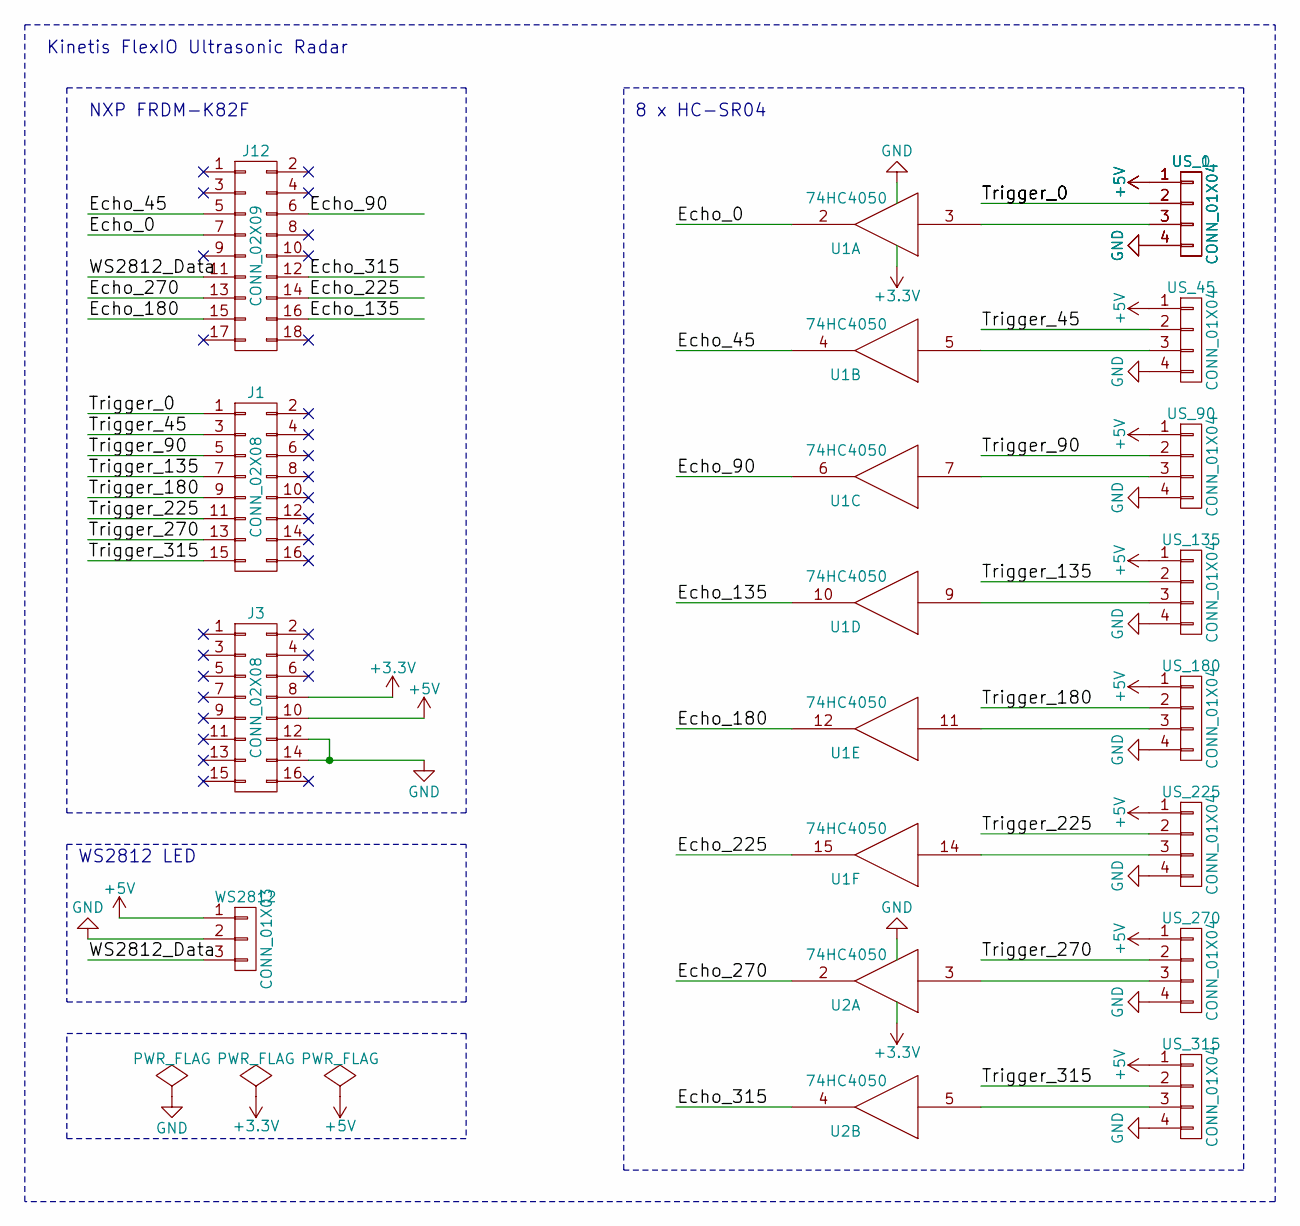
[picture p23: schematic ultrasonicradar.sch]

Parts:
J1, J3: CONN_02X08
J12: CONN_02X09
U1, U2: 74HC4050
US_0, US_1, US_45, US_90, US_135, US_180, US_225, US_270, US_315: CONN_01X04
WS2812: CONN_01X03

Connections:
+3.3V: J3.8, U1.1 (VCC), U2.1 (VCC)
+5V: J3.10, US_0.1, US_1.1, US_45.1, US_90.1, US_135.1, US_180.1, US_225.1, US_270.1, US_315.1, WS2812.1
Echo_0: J12.7, U1.2
Echo_45: J12.5, U1.4
Echo_90: J12.6, U1.6
Echo_135: J12.16, U1.10
Echo_180: J12.15, U1.12
Echo_225: J12.14, U1.15
Echo_270: J12.13, U2.2
Echo_315: J12.12, U2.4
GND: J3.12, J3.14, U1.8 (VSS), U2.8 (VSS), US_0.4, US_1.4, US_45.4, US_90.4, US_135.4, US_180.4, US_225.4, US_270.4, US_315.4, WS2812.2
unnamed: U1.3, US_0.3, US_1.3
unnamed: U1.5, US_45.3
unnamed: U1.7, US_90.3
unnamed: U1.9, US_135.3
unnamed: U1.11, US_180.3
unnamed: U1.14, US_225.3
unnamed: U2.3, US_270.3
unnamed: U2.5, US_315.3
Trigger_0: J1.1, US_0.2, US_1.2
Trigger_45: J1.3, US_45.2
Trigger_90: J1.5, US_90.2
Trigger_135: J1.7, US_135.2
Trigger_180: J1.9, US_180.2
Trigger_225: J1.11, US_225.2
Trigger_270: J1.13, US_270.2
Trigger_315: J1.15, US_315.2
WS2812_Data: J12.11, WS2812.3

Notes on the sheet:
NXP FRDM-K82F
WS2812 LED
8 x HC-SR04
Kinetis FlexIO Ultrasonic Radar
