Shep-pard/stmbl/hw/kicad/rectifier/rescue-backup/rectifier-2020-05-20-21-47-47.sch

## KiCad design hw/kicad/rectifier/rescue-backup/rectifier-2020-05-20-21-47-47.sch (2020-05-30)

Schematic: rectifier-2020-05-20-21-47-47.sch

Parts:
C1: CP1; C_Radial_D35_L51_P10
D1: LED; LED-3MM
D2: DIODE; Diode_DO-41_SOD81_Horizontal_RM10
D3: BRIDGE; dfb_bridge
F1: FUSE; Fuseholder5x20_horiz_SemiClosed_Casing10x25mm
K1: CONN_3; WE313-3
P1, P2, P3: CONN_2; WE313-2
P4: CONN_2; Socket_Strip_Straight_1x02
P5: CONN_1; SolderWirePad_single_2-5mmDrill
R1, R3: R; Resistor_Horizontal_RM10mm
R2: R; Resistor_Vertical_RM7.5mm
RL1, RL2: FINDER-40.52; Relay_DPDT_Schrack-RT2_RM5mm
