Shep-pard/stmbl/(commit log)

2020-04-04 added HW files
    [5i25Breakout-B_Cu.gbl, 5i25Breakout-B_Mask.gbs, 5i25Breakout-B_Paste.gbp, 5i25Breakout-B_SilkS.gbo, 5i25Breakout-Edge_Cuts.gm1, 5i25Breakout-F_Cu.gtl, 5i25Breakout-F_Mask.gts, 5i25Breakout-F_Paste.gtp]
2020-05-18 added IKCM30F60GD
    [11ua.sch, BOM_roh.csv, JLCSMT_BOM_2.xlsx, JLCSMT_BOM_3_STK.xlsx, JLCSMT_CLP_2.xlsx, JLCSMT_CLP_3.xlsx, JLCSMT_CLP_4.xlsx, JLCSMT_CLP_5_STK.xlsx]
2020-05-18 schematic update
    [cmd.sch, ctrl.sch, cur.sch, f3.sch, f4.sch, fb.sch, hv.sch, hv_drive.sch]
2020-05-30 changes for IKCM30F60GD
    [Bom_v1.xlsx, STK.xlsx, f3.sch, hv.sch, hv_drive.sch, hv_supply.sch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]
2020-10-20 some kicad changes
    [5i25Breakout.kicad_pcb, 7i76eEncoderInputs.sch, RJ45.sch, bla.kicad_pcb, bla.sch]
